ddtdanilo/Weather-Station-with-DemoQE128-Estacion-Meteorologica-/SINGUI_actual/data/refresh (2) .png

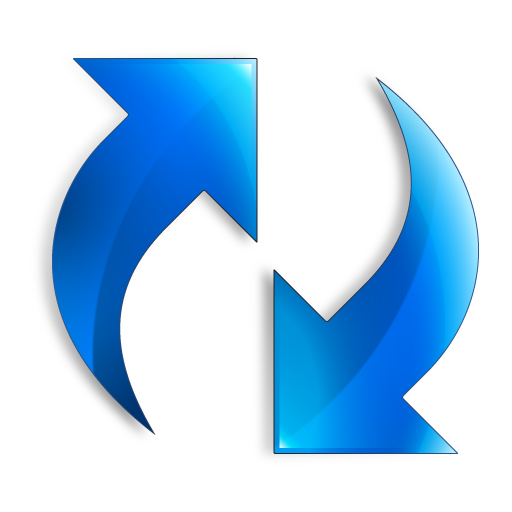
SINGUI_actual/data/refresh (2) .png
