ddtdanilo/Weather-Station-with-DemoQE128-Estacion-Meteorologica-/README.md

Estacion_Meteorologica_Proyectos_II_USB
=======================================

Código relacionado con la Estación Meteorológica -> MCU &amp; Interface PC

Este proyecto fue realizado en la Universidad Simón Bolívar por Danilo Díaz Tarascó e Irene Michelle López Carrón para el 
curso Laboratorio de Proyectos II. Consiste en una estación meteorológica con conexión a la nube, con el objetivo de monitorear
las condiciones de una planta y comunicárselas al usuario. Para esto se utilizaron diversos tipos de sensores, cuyos datos se
enviaron a un canal en ThingSpeak,  a una cuenta de Twitter y se mostraron en una interfaz gráfica desde la cual es usuario 
podía controlar, entre otras cosas, el tiempo de las mediciones.

Para mayor información, puede contactarme a través del siguiente correo: danilodt@gmail.com

Code related to the Weather Station -> MCU & amp; PC Interface 

This project was made at the Simon Bolivar University by Danilo Diaz Tarascó and Irene Michelle Lopez Carrón for the Laboratory of Projects II course. It consists of a weather station with connection to the cloud, in order to monitor the condition of a plant and communicate them to the user. For this, various kinds of sensors where used, taking those data to a ThingSpeak channel, a Twitter account and displayed on a graphical interface from which the user is able to control, among other things, the time of samble of the measurements. 

For more information, you can contact me through the following email: danilodt@gmail.com
