ddtdanilo/Weather-Station-with-DemoQE128-Estacion-Meteorologica-/Informe Final Proyectos II  - 1010211 y 1010391.pdf

## UNIVERSIDAD SIMÓ N BÓLI VAR

## DEPARTAMENTÓ DE ELECTRÓ NICA Y CIRCUITÓS

## LABÓRATÓRIÓ C

EC3882

## PRÓFESÓR: CALÓGERÓ BRUSCIANELLI

# INFORME TÉCNICO: ESTACIÓN METEOROLÓGICA

# LABORATORIO DE PROYECTOS 2

IRENE MICHELLE LÓ PEZ CARRÓ N - USBID: 10-10391.

# ÍNDICE

# TABLA DE CONTENIDOS

Central meteorolo gica para monitoreo de plantas por Medio de La Nube ____________________________________ 1 Implementacio n ___________________________________________________________________________________________________ 2 Sensor de temperatura y humedad del aire DHT11__________________________________________________________ 2 Medicio n de la intensidad de la luz: ___________________________________________________________________________ 4 Medicio n de la temperatura en el suelo: ______________________________________________________________________ 5 Medicio n de la humedad del suelo:____________________________________________________________________________ 7 Medicio n de la velocidad del viento: _________________________________________________________________________10 Tarjeta principal:_______________________________________________________________________________________________19 Microcontrolador: _____________________________________________________________________________________________20 Protocolo de Comunicaciones:________________________________________________________________________________26 Processing: _____________________________________________________________________________________________________27 Recomendaciones ________________________________________________________________________________________________31 Referencias ________________________________________________________________________________________________________32

# TABLA DE FIGURAS

# ÍNDICE

Figura 17 Diagrama de bloques del circuito receptor para el anemo metro ultraso nico | 12
Figura 18 Circuito para la tierra virtual del receptor | 13
Figura 19 Circuito para la etapa inicial de ganancia en el receptor | 13
Figura 20 Circuito para el filtro pasa alto en el receptor | 13
Figura 21 Respuesta en frecuencia del filtro pasa alto, conectado a la etapa inicial de ganancia | 14
Figura 22 Sen al Recibida y la Salida del Comparador (Medida del Error) | 15
Figura 23 Circuito para el comparador en el receptor | 15
Figura 24 Circuito para el divisor de voltaje en el receptor | 16
Figura 25 Circuito receptor del anemo metro ultraso nico para soldar en baquelita perforada | 16
Figura 26 Circuitos para los dos pares emisor-receptor del anemo metro | 17
Figura 27 Diagrama de flujo para el procesamiento de datos del anemo metro | 18
Figura 28 Tarjeta principal para la estacio n meteorolo gica | 19
Figura 29 Diagrama de flujo Microcontrolador, Main | 20
Figura 30 Diagrama de Flujo Interrupcio n Serial SCI1 | 21
Figura 31 Diagrama de Flujo de SCI2 (Proveniente del Sensor de Temperatura y Humedad) | 22
Figura 32 Diagrama de Flujo de la Medicio n de Tiempo 1 | 23
Figura 33 Diagrama de Flujo de la Medicio n de Tiempo 2 | 24
Figura 34 Diagrama de Flujo de la interrupcio n de ADC | 25
Figura 35 Diagrama de flujo del programa en Processing | 27
Figura 36 Interfaz gra fica del programa hecho con Processing | 28
Figura 37 Canal en ThingSpeak que almacena y muestra gra ficamente las mediciones de la estacio n | 29
Figura 38 Publicacio n en Twitter de las mediciones de la estacio n meteorolo gica | 30
Figura 39 Estacio n Metereolo gica | 31

# TABLAS

Tabla 1 Rangos de voltaje correspondientes a las tres categorí as de humedad | 9
Tabla 2 Mediciones Realizadas por el Microcontrolador | 22
Tabla 3 Trama de bytes del protocolo Serial | 26

## CENTRAL METEOROLÓGICA PARA MONITOREO DE PLANTAS POR MEDIO DE LA NUBE

Como proyecto para el curso Laboratorio de Proyectos II se construyo una estacio n meteorolo gica con conexio n a la nube, con el objetivo de monitorear las condiciones de una planta y comunica rselas al usuario. Para esto se utilizaron diversos tipos de sensores, cuyos datos se enviaron a un canal en ThingSpeak, a una cuenta de Twitter y se mostraron en una interfaz gra fica desde la cual es usuario podí a controlar, entre otras cosas, el tiempo de las mediciones.

A continuacio n se presenta un diagrama de bloques que resume la estructura ba sica de la central meteorolo gica para monitoreo de plantas:

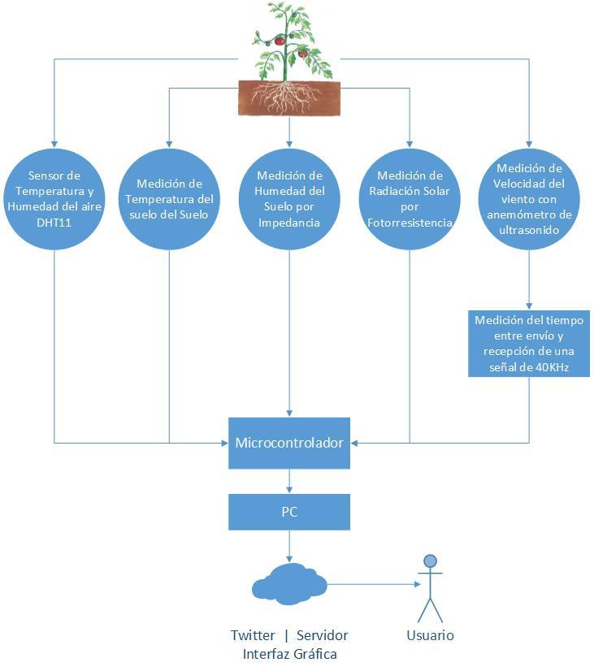
[picture p2: figure]

Figura 1 Diagrama de bloques de la central.

## IMPLEMENTACIÓN

Sensor de temperatura y humedad del aire DHT11

Este sensor se caracteriza por tener la sen al digital calibrada por lo que asegura una alta calidad y una fiabilidad a lo largo del tiempo, ya que contiene un microcontrolador de 8 bits integrado. Esta constituido por dos sensores resistivos. Puede medir la humedad entre el rango 20% – aprox. 95% y la temperatura entre el rango 0ºC – 50ºC.

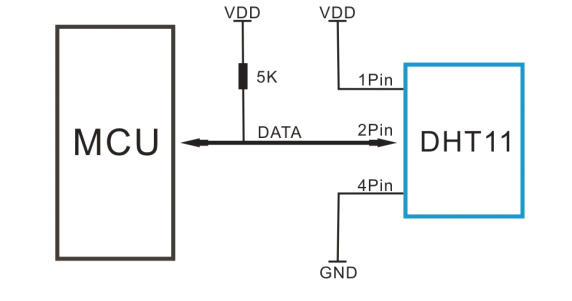
[picture p3: figure]

Figura 2 Implementación circuital del sensor DHT11

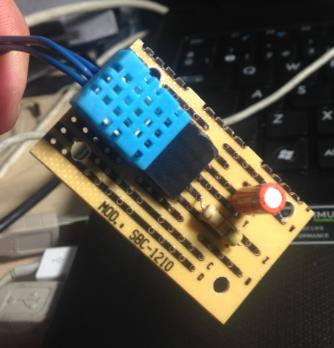
[picture p4: figure]

Figura 3 Sensor DHT11 en su baquelita

Dada la dificultad de implementacio n del protocolo de comunicaciones en el HCS08, se opto por hacer un driver mediante el uso del microcontrolador ATMEGA328PU, y conversores de niveles lo gicos, ya que se tení a la facilidad de usar una librerí a disponible de manera gratuita en la web.

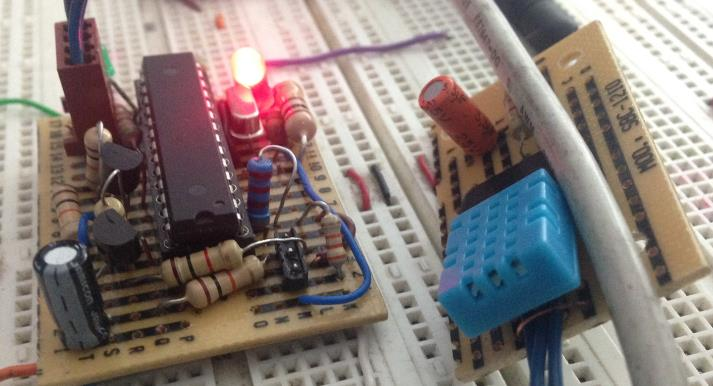
[picture p5: figure]

Figura 4 ATMEGA328PU como Driver del DHT11

La comunicacio n entre microcontroladores se realizo mediante el uso de puerto serial, utilizando el protocolo de comunicaciones explicado de manera detallada ma s adelante.

Medición de la intensidad de la luz:

En cuanto a la medicio n de intensidad de luz, se realizo el montaje de un sensor resistivo mediante la te cnica de divisor de tensio n. Los cambios de voltaje fueron registrados por el ADC del microcontrolador. En la siguiente figura, se puede observar el circuito implementado.

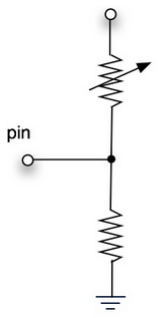
[picture p6: figure]

Figura 5 Divisor de la fotoresistencia

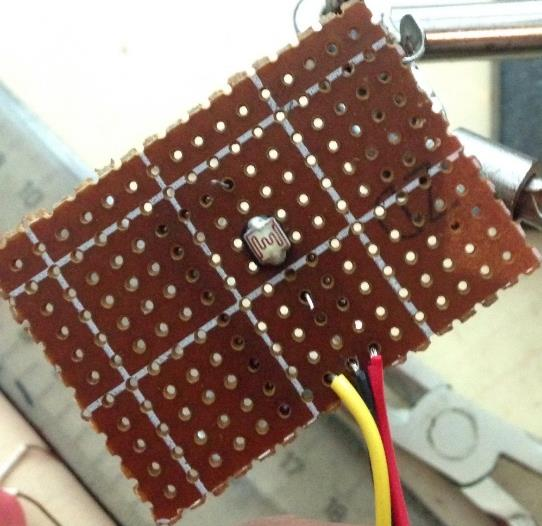
[picture p7: figure]

Figura 6 Sensor de Luminosidad

Para la calibracio n, se realizo el ca lculo de la resistencia del divisor tomando en cuenta los valores ma ximos y mí nimos que presentaba la fotoresistencia y el nu mero de bits de resolucio n del ADC (12 Bits).

La resolucio n final, para 2¹² = 4096, es de 0.7mV. Si se toma en cuenta que para ma xima luminosidad, se tiene una resistencia de 100 Ω, y para mí nima una resistencia de 30 MΩ, se puede llegar a una expresio n para la resistencia necesaria, que permita aprovechar toda la resolucio n del ADC. Se llego a que la resistencia debí a tener un valor aproximado a los 3.9 kΩ.

Medición de la temperatura en el suelo:

Para esta medicio n se empleo el termistor activo MCP9700A, cuyo voltaje de salida es directamente proporcional a la temperatura de su entorno y puede detectar temperaturas de 0°C a 70°C con un error de ±2°C y un consumo de corriente tí pico de 6 µA. Se decidio usar este tipo de sensor en lugar de un termistor resistivo por tener mayor inmunidad a las capacitancias parasitas y ser considerado ma s adecuado para implementaciones donde el sensor se encuentre alejado del circuito principal.

Figura 7 Termistor linear activo de baja potencia MCP9700A

El circuito para el sensor se disen o siguiendo las recomendaciones del Datasheet para disminuir el ruido en las mediciones y puede observarse en la figura 8. La parte del circuito que se enterrara en el suelo comprende el termistor, un condensador de desacoplo y una resistencia, los cuales fueron recubiertos en termoencogible y silico n, como se observa en la figura 9, de forma que no fueran afectados por la humedad del suelo.

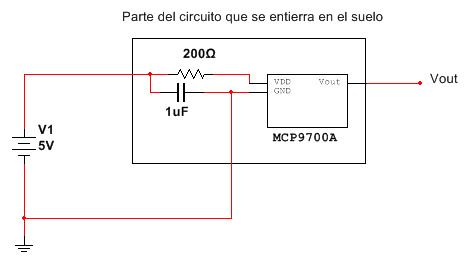
[picture p8: figure]

Figura 8 Circuito para el sensor de temperatura del suelo

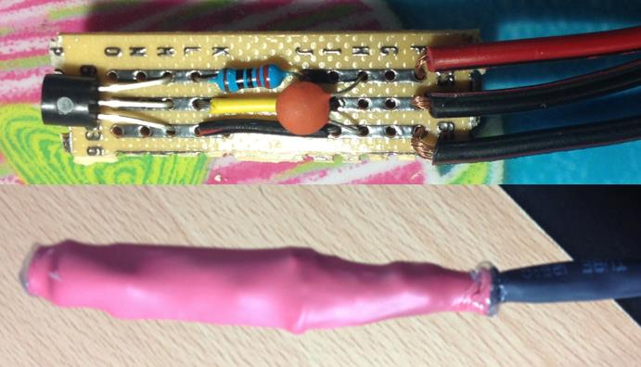
[picture p9: figure]

Figura 9 Sensor de temperatura del suelo, antes y después de cubrirlo

Se decidio conectar la salida del sensor directamente a un pin del microcontrolador, pues la ma xima corriente de salida especificada en el Datasheet es de 100uA, mientras que el ma ximo voltaje de salida es de aproximadamente 1.75V, como puede observarse en la siguiente gra fica:

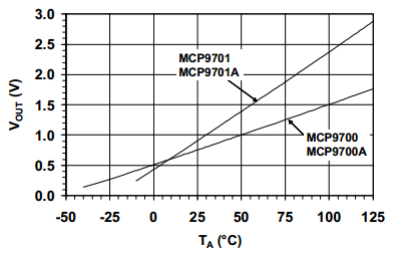
[picture p10: figure]

Figura 10 Voltaje de Salida vs. Temperatura para una alimentación entre 1.5V y 5.5V

Para obtener la temperatura a partir del voltaje de salida del sensor, se aplico la siguiente fo rmula:

Temperatura =

(Vout_sensor ∗

3
4096)− 0.5

0.01

Donde 3 es el voltaje ma ximo en el pin analo gico, 4096 es 2

12 , la resolucio n del conversor analo gico-digital, 0.5 equivale a 500mV, el voltaje de salida del sensor para 0°C y 0.01 representa el factor de 10mV/°C del sensor.

Medición de la humedad del suelo:

Para medir la humedad del suelo se empleo el circuito que puede observarse en la figura 11. Los clavos meta licos se entierran en el suelo, que actu a como una resistencia variable, conduciendo electricidad en mayor o menor medida, dependiendo de su humedad. La resistencia del suelo disminuye cuando aumenta la cantidad de agua que contiene e incrementa a medida que se seca; esto implica que con el circuito utilizado, mientras mayor sea la humedad del suelo, mayor sera el voltaje en el pin analo gico.

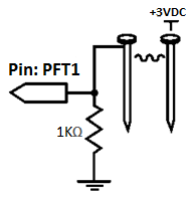
[picture p11: figure]

Figura 11 Circuito para medición de humedad en el suelo

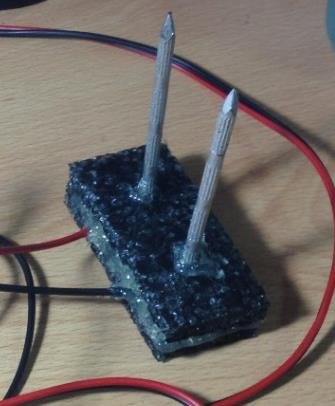
[picture p12: figure]

Figura 12 Terminales metálicos

Al medir con un multí metro la resistencia entre los terminales meta licos, enterrados en la tierra de una maceta, se observo que la medicio n variaba ligeramente de un instante a otro, aunque la temperatura y humedad se mantení an constantes. Esto se debí a a que los clavos empleados no eran adecuados, pues no se encontraban galvanizados y empezaban a sufrir un proceso de electro lisis al estar en contacto con el agua y tener una corriente circulando entre ellos. Adicionalmente, el sensor tení a que mantenerse un tiempo prolongado en la tierra, para obtener una medicio n lo suficientemente estable.

Tomando en cuenta ambos factores se decidio no mostrar la humedad en porcentajes, como se tení a planeado inicialmente, optando por dar a la medicio n un enfoque ma s pra ctico y enfocado al usuario final; para esto se dividio la humedad del suelo en tres categorí as: “Baja”, “Ó ptima” y “Excesiva”.

Para medir de forma adecuada la humedad del suelo, fue necesario considerar tambie n su temperatura, pues cuando e sta aumenta la resistencia del suelo disminuye y al bajar la temperatura la resistencia se incrementa.

Como las propiedades del suelo varí an de acuerdo a su tipo y a los minerales que contenga, se tuvo que encontrar de forma pra ctica la relacio n entre la resistencia y temperatura, pudiendo observarse la gra fica obtenida en la figura 13. Las mediciones se realizaron usando una mezcla de 200cc de agua con 60cc de tierra, para garantizar que la humedad no disminuyera con la evaporacio n al calentar la mezcla y que no aumentara al colocarla en el congelador para disminuir su temperatura.

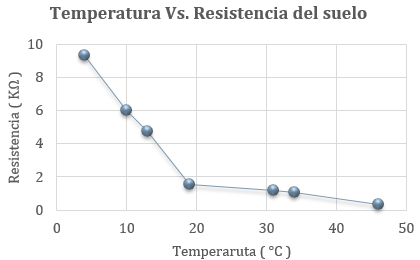
[picture p13: figure]

Figura 13 Gráfica de Temperatura Vs. Resistencia del Suelo

Como la variacio n de resistencia fue muy baja entre 19°C y 31°C, se decidio considerarla constante para dicho intervalo. Al realizar la correccio n de la resistencia en el co digo, se considero una recta con pendiente -500 para temperaturas menores a los 19°C y otra con pendiente -58 para temperaturas superiores a los 31°C, de forma que la resistencia “real”, llevada al intervalo entre 19°C y 31°C, pudiera obtenerse mediante la aplicacio n de una de las siguientes fo rmulas, segu n correspondiera:

Resistencia real = −500 ∗ ( 19 − temperatura medida, menor a 19°C)+ Resistencia medida

ó

Resistencia real = −58 ∗ ( 31 − temperatura medida, mayor a 31°C)+ Resistencia medida

Óbteniendo el voltaje en la salida del divisor con la siguiente relacio n: Voltaje real =

1kΩ ∗3V
Resistencia real+ 1kΩ

Para finalizar se midio a 25°C el voltaje a la salida del divisor, estableciendo los rangos correspondientes a las tres clasificaciones de humedad:

Humedad | Baja | Óptima | Excesiva
Voltaje en el pin analógico | Menor a 0.84V | Entre 0.84V y 1.69V | Mayor a 1.69V

Tabla 1 Rangos de voltaje correspondientes a las tres categorías de humedad

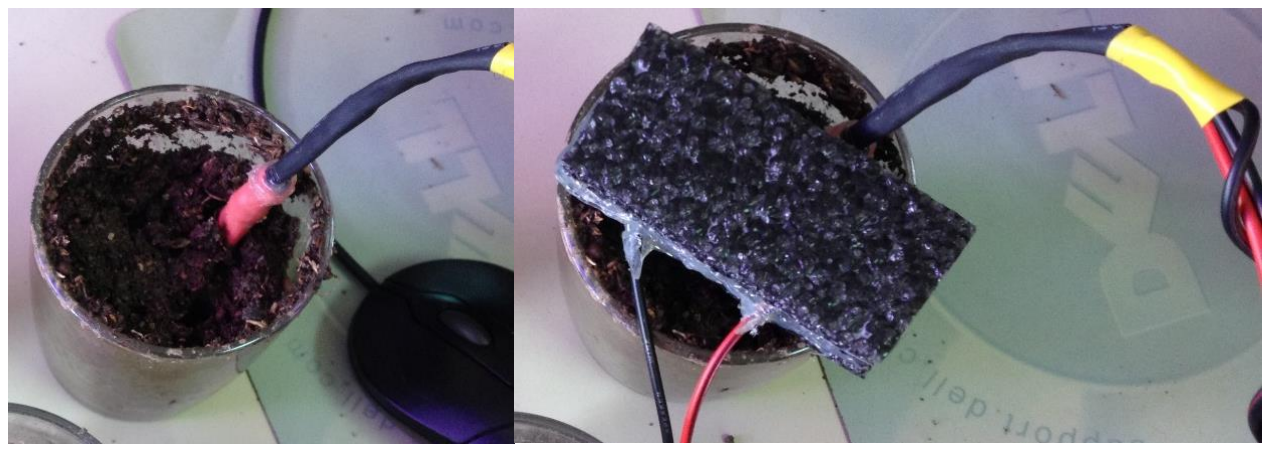
[picture p14: figure]

Figura 14 Medición de la humedad del suelo, con corrección de temperatura

Medición de la velocidad del viento:

Para realizar e sta medicio n se construyo un anemo metro de ultrasonido, que funciona mediante la medicio n del tiempo que tarda una sen al a 40KHz en llegar del emisor a un receptor ubicado frente a e l, a una distancia D conocida. El instrumento construido puede observarse en la figura 15 y cuenta con 4 cornetas, dos de las cuales actu an como emisor y las otras dos como receptor.

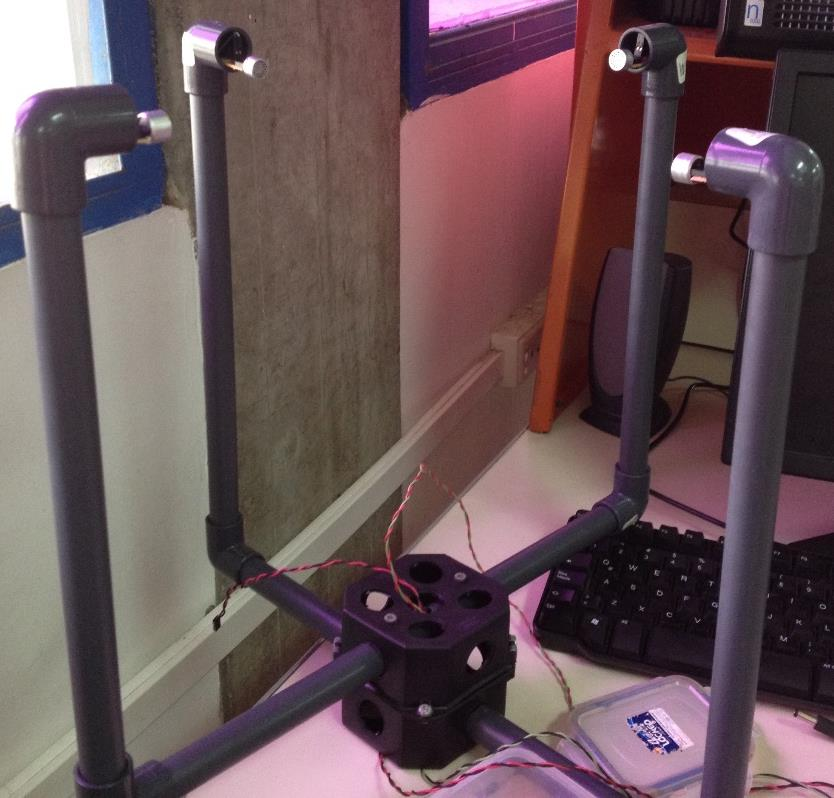
[picture p15: figure]

Figura 15 Anemómetro ultrasónico.

El funcionamiento de e ste dispositivo se basa en lo siguiente: Suponiendo que se tienen los sensores separados a una distancia D, el tiempo que tarda la sen al desde el emisor 1 hasta el receptor 1 con viento es:

t1 = D/(vs ±Vx)

Dado que la velocidad del sonido (vs) es lineal y proporcional a la temperatura, para temperaturas cercanas a la ambiente, se obtiene la velocidad del sonido haciendo uso de la temperatura obtenida con el sensor DHT11:

vs ≈ 331.4 +0.61 · temp [1]

Usando las fo rmulas anteriores se obtiene la componente de la velocidad del viento Vx y aplicando el mismo procedimiento en un segundo par emisor-receptor, ubicado de forma perpendicular al primero, se obtiene la otra componente de la velocidad del viento, Vy. De esta manera se puede obtener la velocidad V del viento y su a ngulo α de incidencia, mediante:

α = arctan(

Vy
Vx)

V = √Vx
2 + Vy

2

◊ Emisor ultrasónico:

Se genera una PWM con el microcontrolador, de frecuencia de 40KHz y que se enví a hasta que se detecta el primer flanco de bajada en el receptor. Dicha sen al tiene un voltaje ma ximo de 3 voltios, lo cual no es suficiente para el emisor ultraso nico, que es poco eficiente y necesita recibir una sen al de alto voltaje, de forma que el receptor pueda captarla despue s de las perdidas y contaminacio n con ruido.

Por esa razo n, la sen al del microcontrolador se usa como entrada para el circuito de la figura 16, el cual aumenta el voltaje de la sen al recibida a 15 voltios. A la entrada “SIG-“ se conecta la salida de una compuerta lo gica Not o Inversor, que invierte la sen al obtenida del microcontrolador; dicha sen al se emplea directamente para la entrada “SIG+”. De esta forma solo es necesario generar con el microcontrolador una PWM por cada par emisor-receptor.

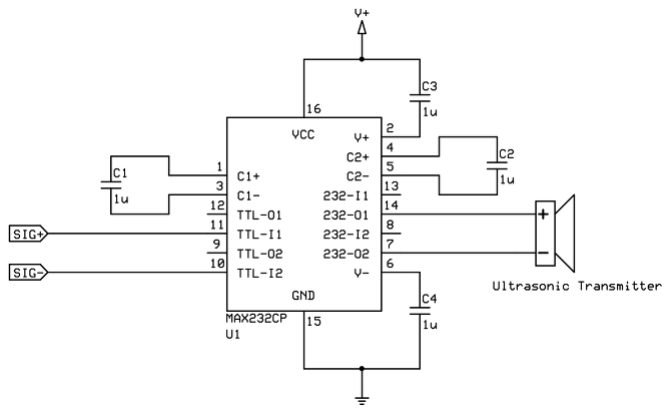
[picture p16: figure]

Figura 16 Circuito para el emisor del anemómetro ultrasónico

Cuando el microcontrolador genera la PWM, empieza un contador que se detendra al llegar la sen al al receptor, enviando por serial el tiempo de tra nsito medido.

◊ Receptor ultrasónico:

La sen al captada por el receptor ultraso nico era de bajo voltaje y se encontraba muy contaminada por ruido de frecuencia 60Hz, proveniente de las lí neas ele ctricas. Por ello, resulto necesario acondicionar la sen al antes de enviarla al microcontrolador.

En la figura 17 se puede observar el diagrama de bloques del circuito de acondicionamiento para la sen al captada por el receptor ultraso nico.

El bloque de nombre “GNDV” es la tierra virtual, una sen al DC de 2,5 voltios. Es necesario emplear una tierra virtual para los bloques de amplificacio n y filtro pasa alto, pues en ambos se utiliza un amplificador operacional, alimentado en modo single supply, de 0 a 5 voltios; la tierra virtual actu a como un offset, subiendo el nivel de la sen al, que originalmente puede tener componentes negativas, no aceptables para un amplificador alimentado u nicamente con voltajes positivos.

Los circuitos para la tierra virtual, etapa inicial de ganancia y filtro pasa alto activo, pueden observarse en las ima genes 18, 19 y 20 respectivamente. No se coloco un filtro pasa bajo para antisolapamiento, pues la ganancia del filtro pasa alto en conjunto con el ancho de banda del amplificador utilizado, el LM324N, hacen que el filtro pasa alto se comporte como un pasa banda. En la figura 21 se encuentra la respuesta en frecuencia del filtro pasa alto conectado a la etapa de ganancia y como se puede observar, para una frecuencia de 40KHz ya empieza a presentarse una reduccio n de la ganancia, lo que confirma que la implementacio n de un filtro pasa bajo no es necesaria.

Figura 17 Diagrama de bloques del circuito receptor para el anemómetro ultrasónico

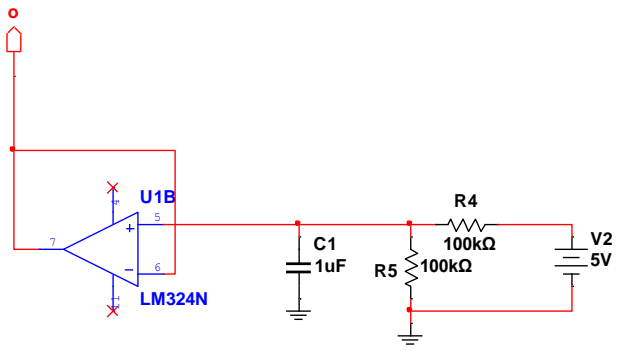
[picture p17: figure]

Figura 18 Circuito para la tierra virtual del receptor

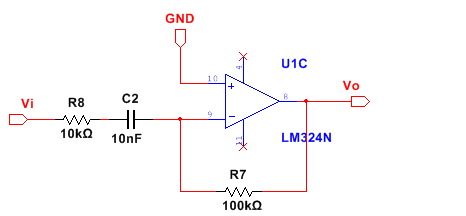
[picture p18: figure]

Figura 19 Circuito para la etapa inicial de ganancia en el receptor

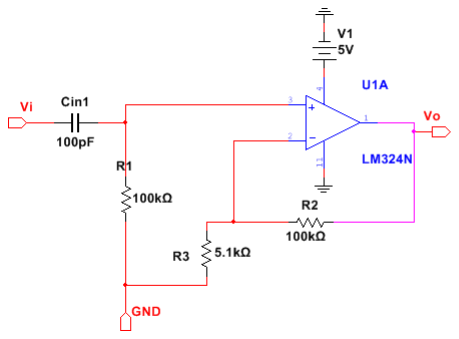
[picture p19: figure]

Figura 20 Circuito para el filtro pasa alto en el receptor

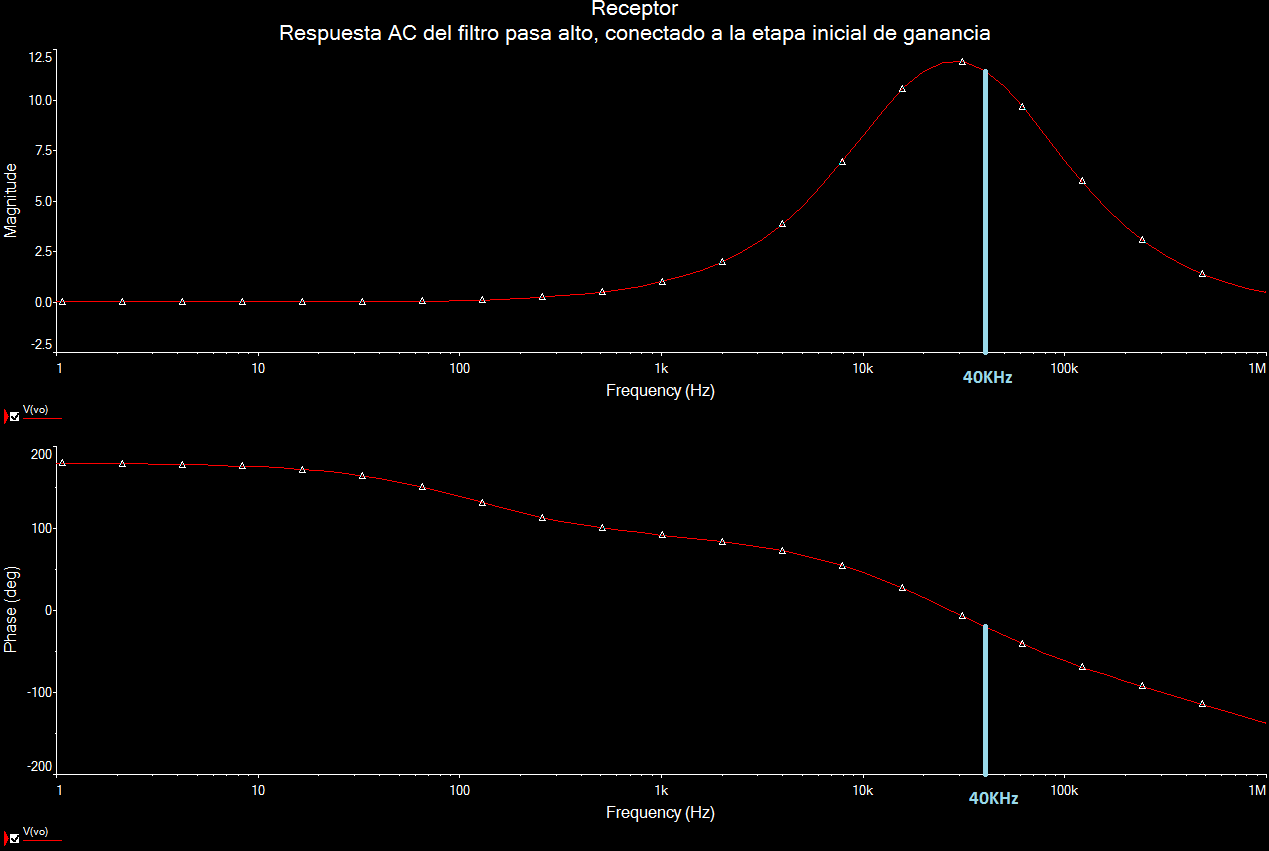
[picture p20: figure]

Figura 21 Respuesta en frecuencia del filtro pasa alto, conectado a la etapa inicial de ganancia

En la figura 23, se puede observar un circuito que emplea el LM311P. Su propo sito es comparar la sen al proveniente del filtro pasa alto, “Vin”, con un voltaje de comparacio n o threshold. Cuando el voltaje de “Vin” es mayor al de comparacio n, la salida del comparador es un DC de 5 voltios, en caso contrario dicha salida es cero. Se opto por usar un potencio metro para establecer el voltaje de comparacio n, de forma que el circuito fuera ma s pra ctico de calibrar; para elegir dicho voltaje se consideraron los siguientes factores:

- La sen al presentaba ruido de alta frecuencia, en apariencia aleatorio, elevado tambie n por el offset de 2.5V y que podí a tener picos mayores a 500mV.
- El amplificador operacional utilizado se saturaba a un voltaje de aproximadamente 3.5 voltios.

Tomando ambos hechos en cuenta, se decidio usar un voltaje de comparacio n de 800mV, de forma que la salida del comparador se mantuviera siempre en 5V y bajara a 0V al recibir el primer flanco de bajada de la sen al. Con esto se garantizo que ningu n pico del ruido pudiera confundirse por la llegada de la sen al, la cual tení a una voltaje pico de aproximadamente 2 Voltios, llegando de 500mV a los 3.5V que permití a el amplificador.

Con el nuevo voltaje de comparacio n se comprobo que el receptor no confundí a los picos de ruido con la sen al del emisor, sin embargo, se presentaba de forma espora dica un incremento en la velocidad medida, aun en ambientes cerrados y pra cticamente sin viento. A trave s de mu ltiples mediciones, se observo que dicho aumento siempre se encontraba alrededor de 25us y el estudio de la onda recibida con el osciloscopio permitio llegar a la conclusio n de que en ocasiones la atenuacio n de la sen al durante el enví o era excesiva y no se lograba detectar el primer ciclo de la sen al; se incremento la amplificacio n de la segunda etapa de ganancia y el voltaje de comparacio n, pero aun así se seguí a perdiendo espora dicamente el primer ciclo de la sen al, por lo que se opto por hacer un promedio de diez mediciones en el co digo, de forma que el error en una de ellas no afectara de forma significativa la velocidad final obtenida. Dicha solucio n permitio obtener valores mucho ma s estables en la medicio n y no ralentizo el co digo, pues cada medicio n de tiempo tomaba menos de 2ms.

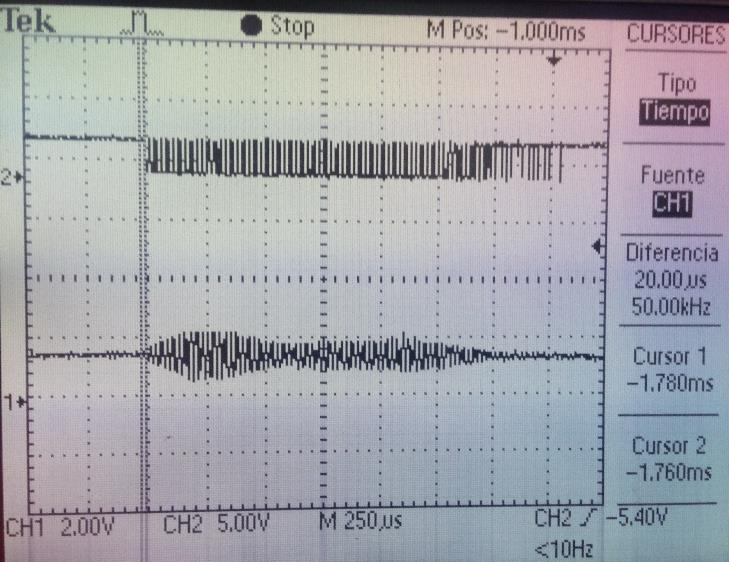
[picture p21: figure]

Figura 22 Señal Recibida y la Salida del Comparador (Medida del Error)

Como el microcontrolador solo acepta entradas de 0 a 3 voltios y el comparador genera sen ales entre 0 y 5 voltios, fue necesario usar un divisor de voltaje como el que puede observarse en la figura 24. Cuando el microcontrolador detecta el primer flanco de bajada en la sen al de salida del divisor, se detiene el contador y se enví a la medida al programa en Processing, donde se realizan correcciones en el tiempo medido, multiplica ndolo por el step del contador y suma ndole una constante obtenida al calibrar el anemo metro en un espacio sin viento, donde la velocidad de la onda de 40KHz debí a ser igual a la velocidad del sonido.

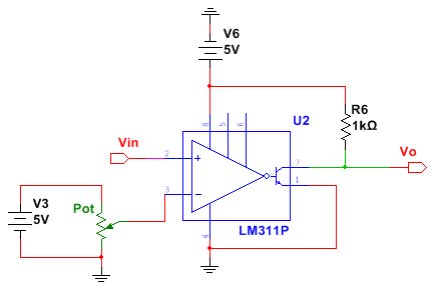
[picture p22: figure]

Figura 23 Circuito para el comparador en el receptor

Figura 24 Circuito para el divisor de voltaje en el receptor

Cada par emisor-receptor requerí a un circuito como el de la figura 25, por ello, se decidio organizar ambos circuitos para que la tarjeta correspondiente al segundo par, encajara sobre la del primero, de tal forma que el circuito inferior recibiera la alimentacio n y las sen ales del microcontrolador, mientras que en el circuito superior solo se conectaban las cuatro cornetas. El resultado obtenido puede observarse en la figura 26.

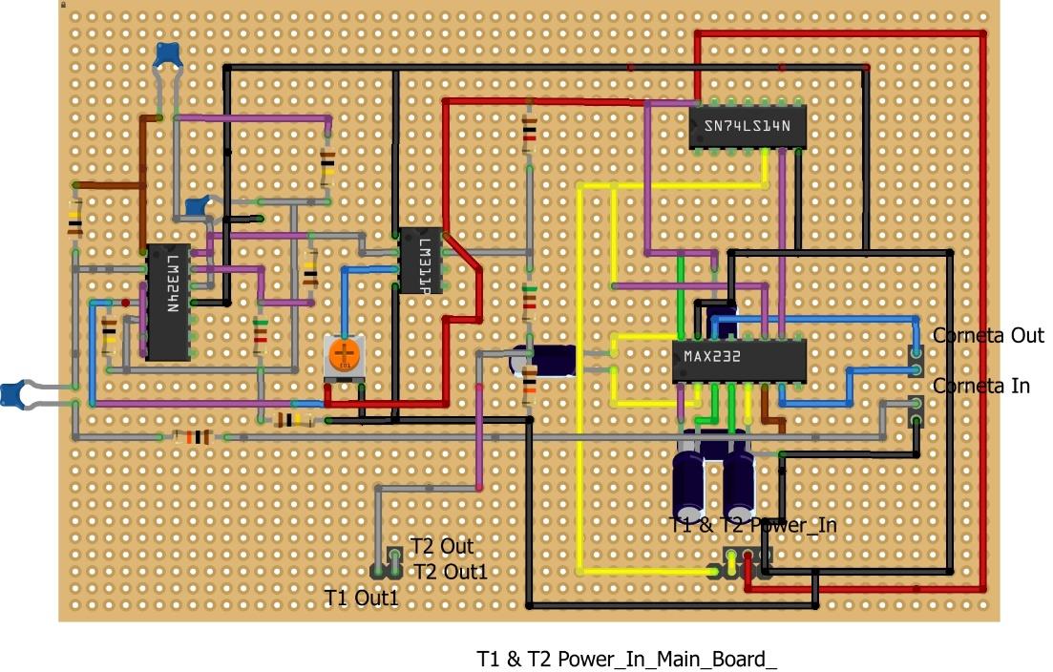
[picture p23: figure]

Figura 25 Circuito receptor del anemómetro ultrasónico para soldar en baquelita perforada

IO1 | R9 | IO2
| 47kΩ
| | R12

56kΩ

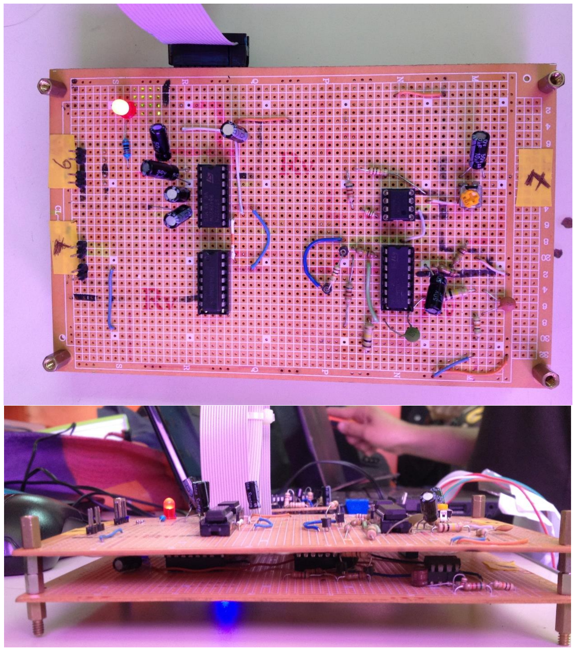
[picture p24: figure]

Figura 26 Circuitos para los dos pares emisor-receptor del anemómetro

A continuacio n se tiene un diagrama de flujo para el procesamiento de datos provenientes del anemo metro.

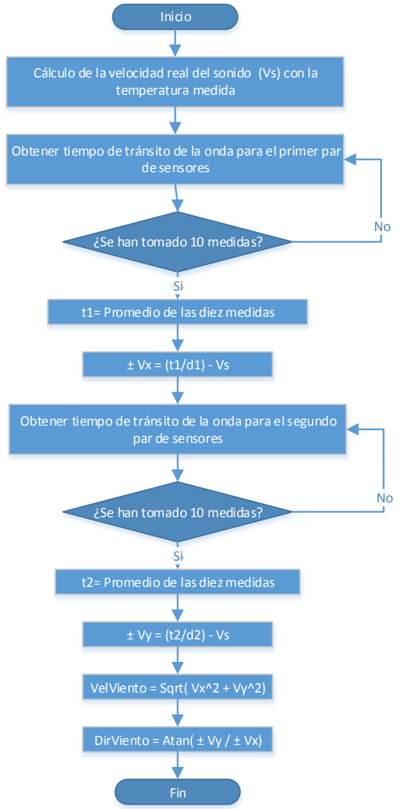
[picture p25: figure]
Inicio; temperatura medida; de sensores; par de sensores; Fin; ¿Se han tomado 10 medidas?; t1= Promedio de las diez medidas; t2= Promedio de las diez medidas; VelViento = Sqrt( Vx^2 + Vy^2); DirViento = Atan( ± Vy / ± Vx)

Cálculo de la velocidad real del sonido (Vs) con la

Obtener tiempo de tránsito de la onda para el primer par

Obtener tiempo de tránsito de la onda para el segundo

Figura 27 Diagrama de flujo para el procesamiento de datos del anemómetro

Tarjeta principal:

Una vez construidos los sensores de forma individual, resulto necesaria una tarjeta principal donde se conectaran todos, para alimentarlos y comunicarlos con el microcontrolador. En dicha tarjeta se coloco un conector para el microcontrolador y los distintos conectores requeridos por cada sensor. Tambie n se agrego un conector para puerto serial inala mbrico y la alimentacio n de 5 voltios, para la cual se uso un regulador de 5 voltios, con un capacitor de 100uF en paralelo a otro de 0.1uF a la salida, con propo sito de filtrado. El circuito obtenido se puede observar en la siguiente figura:

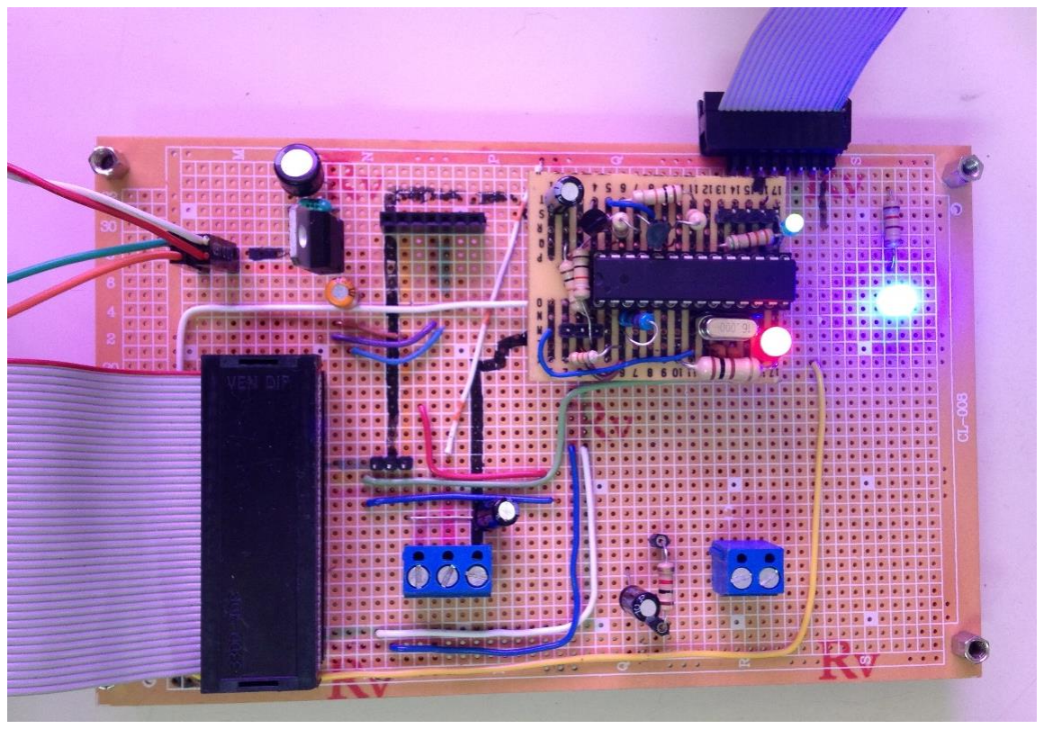
[picture p26: figure]

Figura 28 Tarjeta principal para la estación meteorológica

Microcontrolador:
Los datos se obtendra n a trave s del microcontrolador, que a su vez se comunicara por un protocolo de comunicacio n a disen ar con la plataforma PC. Esta plataforma permitira enviar a la nube los datos adquiridos mediante la aplicacio n desarrollada en Processing.

Dada la cantidad de procesos que el microcontrolador debí a llevar a cabo, se decidio atacar este problema de co mputo mediante el uso modular de interrupciones, dado que facilitan la implementacio n del co digo necesario de manera modular y separada.

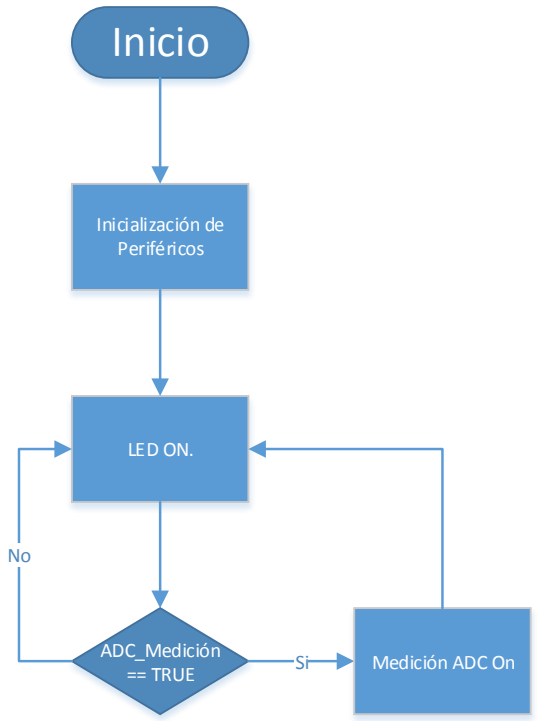
[picture p27: figure]
Inicio; Inicialización de Periféricos; LED ON.; ADC_Medición; == TRUE; Medición ADC On

Figura 29 Diagrama de flujo Microcontrolador, Main

Para la recepcio n serial SCI1, que se debí a comunicar con la PC, se implemento una estructura switch, que permitio separar las peticiones de la PC. En esta estructura se realiza el algoritmo correspondiente a cada una de las mediciones.

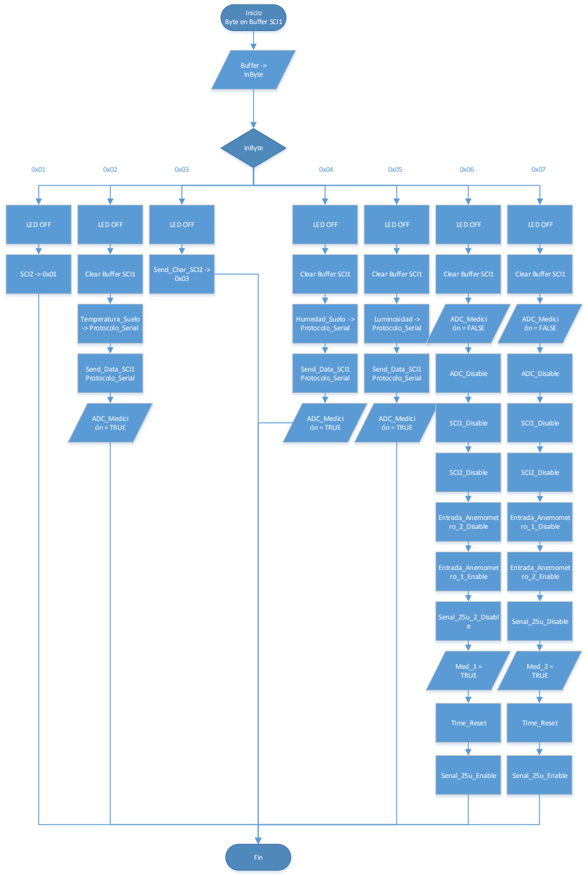
[picture p28: figure]
Inicio Byte en Buffer SCI1; Buffer -> inByte; LED OFF; inByte; SCI2 -> 0x01; Clear Buffer SCI1; Temperatura_Suelo -> Protocolo_Serial; Send_Data_SCI1 Protocolo_Serial; Send_Char_SCI2 ->; Humedad_Suelo -> Protocolo_Serial; Luminosidad -> Protocolo_Serial; ADC_Medici ón = TRUE; ADC_Medici ón = FALSE; ADC_Disable; SCI1_Disable; SCI2_Disable; Entrada_Anemomet ro_2_Disable; Entrada_Anemomet ro_1_Enable; Senal_25u_2_Disabl e; Med_1 = TRUE; Time_Reset; Senal_25u_Enable; Entrada_Anemomet ro_1_Disable; Entrada_Anemomet ro_2_Enable; Senal_25u_Disable; Med_2 = TRUE; Fin

Figura 30 Diagrama de Flujo Interrupción Serial SCI1

En la siguiente tabla se puede observar las mediciones que realiza el microcontrolador y los respectivos nu meros hexadecimales para ser solicitados mediante el puerto serial SCI1.

Medición | Número Hexadecimal
Temperatura Ambiental | 0x01
Temperatura del Suelo | 0x02
Humedad del Ambiente | 0x03
Humedad del Suelo | 0x04
Luminosidad | 0x05
Tiempo de Anemómetro 1 | 0x06
Tiempo de Anemómetro 2 | 0x07

Tabla 2 Mediciones Realizadas por el Microcontrolador

Dado que la medicio n de Temperatura y humedad del ambiente se realizan en el sensor DHT11, se debe comunicar mediante el driver disen ado. A continuacio n se puede ver el diagrama de flujo de la interrupcio n del SCI2, que interactu a con el ATMEGA328PU.

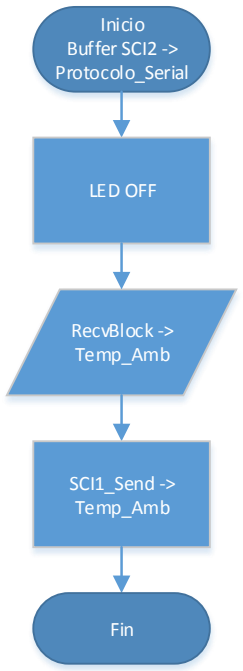
[picture p29: figure]
Inicio Buffer SCI2 -> Protocolo_Serial; LED OFF; RecvBlock -> Temp_Amb; SCI1_Send -> Temp_Amb; Fin

Figura 31 Diagrama de Flujo de SCI2 (Proveniente del Sensor de Temperatura y Humedad)

En cuanto a la medicio n de tiempo de tra nsito de la sen al generada de 40 kHz, en el eje X y el eje Y (Componentes de la velocidad del tiempo), les corresponde los siguientes diagramas de flujo.

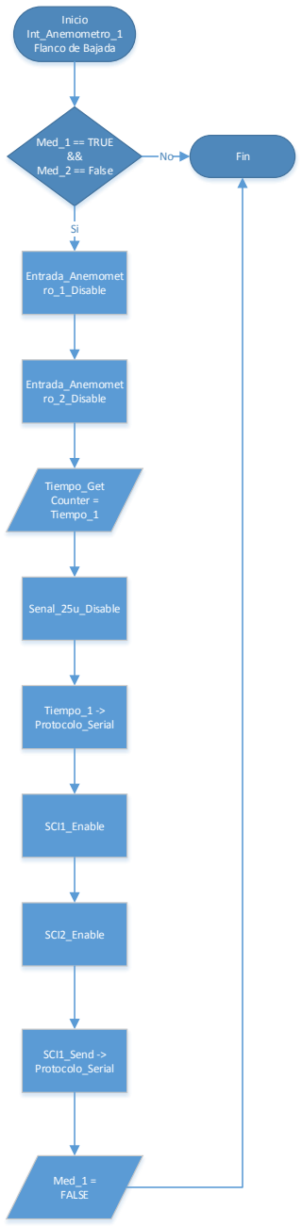
[picture p30: figure]
Inicio Int_Anemometro_1 Flanco de Bajada; Med_1 == TRUE && Med_2 == False; Entrada_Anemomet ro_1_Disable; Fin; Entrada_Anemomet ro_2_Disable; Tiempo_Get Counter = Tiempo_1; Senal_25u_Disable; Tiempo_1 -> Protocolo_Serial; SCI1_Enable; SCI2_Enable; SCI1_Send -> Protocolo_Serial; Med_1 = FALSE

Figura 32 Diagrama de Flujo de la Medición de Tiempo 1

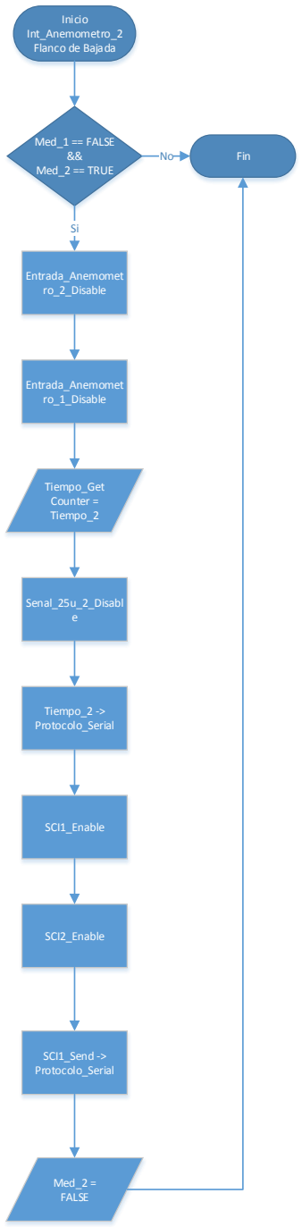
[picture p31: figure]
Inicio Int_Anemometro_2 Flanco de Bajada; Med_1 == FALSE && Med_2 == TRUE; Entrada_Anemomet ro_2_Disable; Fin; Entrada_Anemomet ro_1_Disable; Tiempo_Get Counter = Tiempo_2; Senal_25u_2_Disabl e; Tiempo_2 -> Protocolo_Serial; SCI1_Enable; SCI2_Enable; SCI1_Send -> Protocolo_Serial; Med_2 = FALSE

Figura 33 Diagrama de Flujo de la Medición de Tiempo 2

La manera como se disen o el co digo de obtencio n de tiempo de tra nsito, permitio que se realizara la medicio n de manera que el tiempo se viera afectado en lo ma s mí nimo por los dema s perife ricos, mediciones, eventos, etc.

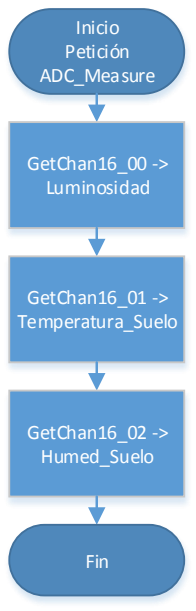
[picture p32: figure]
Inicio Petición ADC_Measure; GetChan16_00 -> Luminosidad; GetChan16_01 -> Temperatura_Suelo; GetChan16_02 -> Humed_Suelo; Fin

Figura 34 Diagrama de Flujo de la interrupción de ADC

En cuanto a la figura anterior, se puede observar que cuando la interrupcio n del ADC se lleva a cabo, realiza mediciones con una resolucio n de 16 Bits, y se guardan los valores para su posterior enví o.

Protocolo de Comunicaciones:

Un protocolo de comunicaciones es un conjunto de reglas y normas que permiten que dos o ma s entidades de un sistema se comuniquen para transmitir de relevancia. Se trata de las reglas o esta ndares que define la sintaxis, sema ntica y sincronizacio n de la comunicacio n, así como posibles me todos de recuperacio n de errores. Los protocolos pueden ser implementados por hardware, software, o una combinacio n de ambos.

Para el caso de la comunicacio n entre el microcontrolador, la PC y el Atmel328PU, se disen o un protocolo de comunicaciones digital, adecuado a la transmisio n por puerto serial. Este protocolo consta de una trama de cinco bytes, como se puede ver a continuacio n.

** | ** | ** | ** | 0XFF
0 | 1 | 2 | 3 | 4
Tabla 3 Trama de bytes del protocolo Serial.

Cada uno de estos Byte indica informacio n relevante para el receptor.

- Byte 0: Indica el tipo de dato enviado (Sensor).
- Byte 1: Indica DATA1, los bits ma s significativos de la medida.
- Byte 2: Indica DATA2, los bits menos significativos de la medida.
- Byte 3: Indica si en DATA1 o en DATA2 hubo 0xFF. Si fue en DATA1, enví a 0x01, si fue en DATA2, enví a 0x02, si fue en DATA1 y DATA2, enví a 0x03. Caso contrario enví a 0x00 (No hay 0xFF en la medida).
- Byte 4: Indica el fin de la trama enviada con 0xFF.

Este protocolo tiene como bondad, que se puede realizar una transmisio n de 16 Bit de informacio n, con indicacio n del tipo de dato y fin de trama.

Processing:

Para el procesamiento de los datos obtenidos por el microcontrolador y la comunicacio n con el usuario, se empleo un co digo en Processing 1.0, el cual hacia uso de varias librerí as, entre ellas twitter4j para publicar los datos en twitter y G4P para construir la interfaz gra fica con mayor facilidad. En la siguiente figura se puede observar el diagrama de flujo del funcionamiento principal del programa:

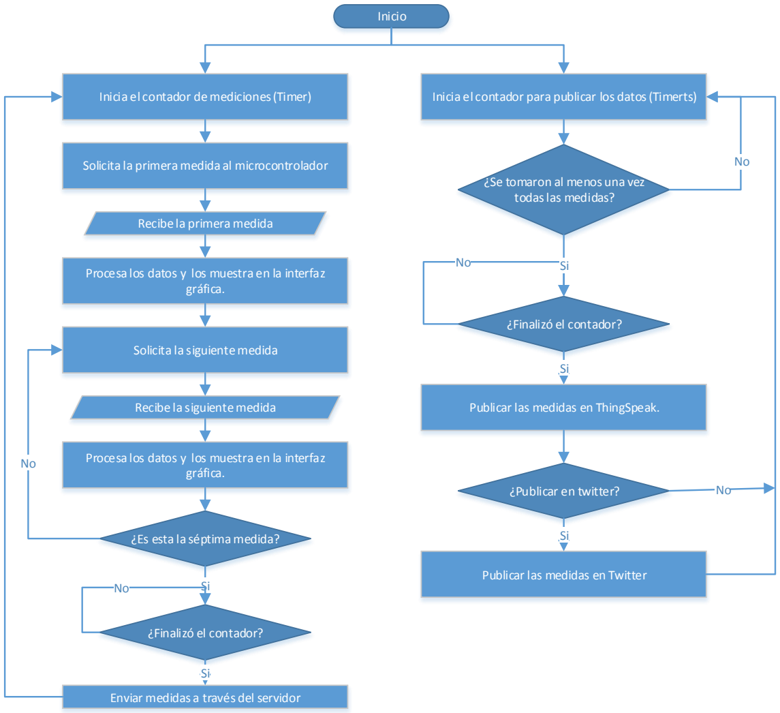
[picture p33: figure]
Inicio; ¿Es esta la séptima medida?; Recibe la primera medida; gráfica.; Recibe la siguiente medida; Solicita la siguiente medida; ¿Finalizó el contador?; ¿Se tomaron al menos una vez todas las medidas?; Enviar medidas a través del servidor; Publicar las medidas en ThingSpeak.; ¿Publicar en twitter?; Publicar las medidas en Twitter

Inicia el contador de mediciones (Timer)

Solicita la primera medida al microcontrolador

Inicia el contador para publicar los datos (Timerts)

Procesa los datos y los muestra en la interfaz

Procesa los datos y los muestra en la interfaz

Figura 35 Diagrama de flujo del programa en Processing

La interfaz gra fica del programa se puede observar en la siguiente figura y permite elegir el puerto serial a utilizar, la frecuencia con la cual se realizan las mediciones y si se publicaran o no en twitter; tambie n permite realizar mediciones de forma individual al presionar el boto n de “refrescar”, ubicado al lado de la medicio n correspondiente. Para la medicio n de velocidad y direccio n del viento se agrego una flecha que muestra en grados la direccio n y varí a su longitud, segu n la velocidad medida.

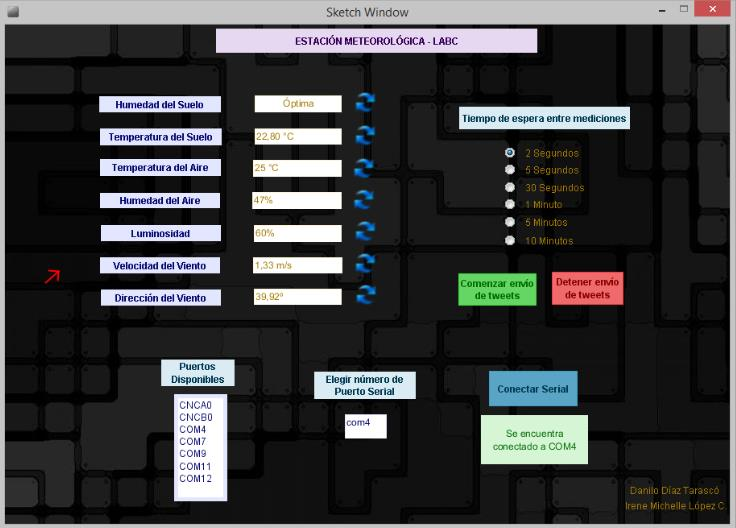
[picture p34: figure]

Figura 36 Interfaz gráfica del programa hecho con Processing

Como uno de los objetivos de la estacio n meteorolo gica era poder monitorear las variables de forma remota, se creo una cuenta de Twitter y un Canal en ThingSpeak para publicar las mediciones. Una muestra de la informacio n publicada en ambas pa ginas se puede observar en las siguientes ima genes:

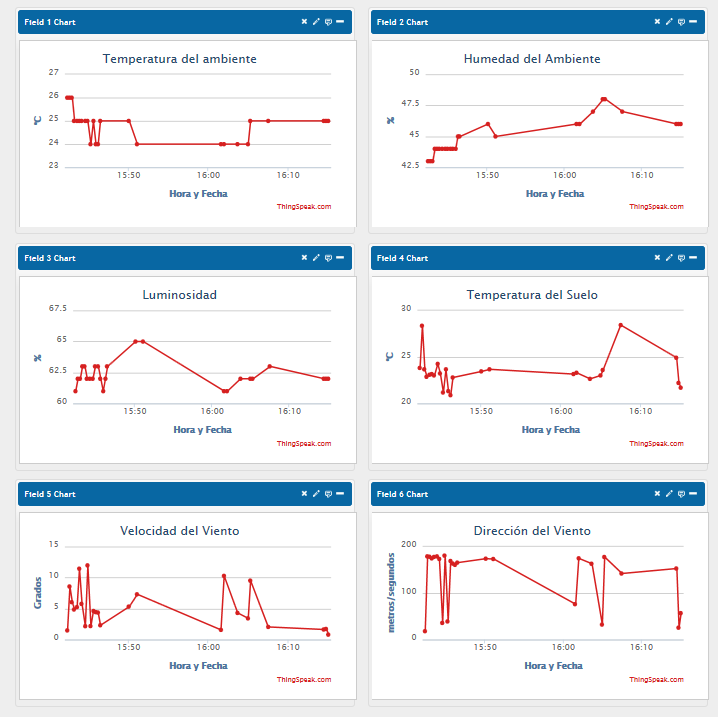
[picture p35: figure]

Figura 37 Canal en ThingSpeak que almacena y muestra gráficamente las mediciones de la estación

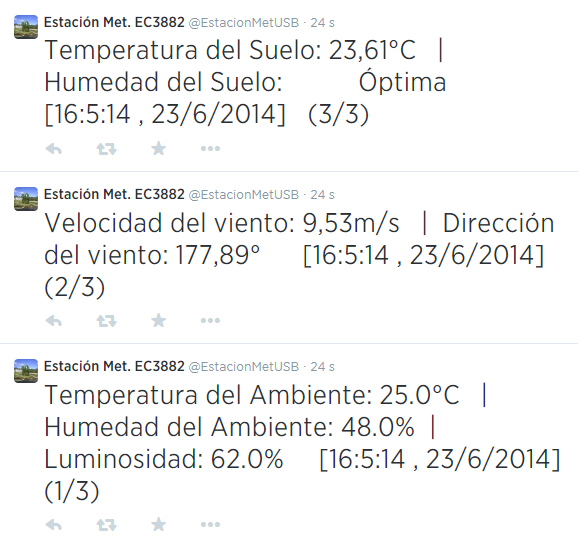
[picture p36: figure]

Figura 38 Publicación en Twitter de las mediciones de la estación meteorológica

### RECOMENDACIONES

El resultado del proyecto fue satisfactorio, pero se recomienda para su pro xima versio n los siguientes puntos:

- Si bien habí a la posibilidad de realizar una multiplexacio n de los emisores y receptores ultraso nicos, si no se desea obtener la temperatura, se recomienda el uso de emisores y receptores fijos es una buena solucio n, ya que la calibracio n es sencilla.
- Se recomienda conseguir clavos galvanizados para evitar la electro lisis en el circuito de sensor de humedad del suelo.
- Si se dispone de tiempo, es recomendable desarrollar una librerí a que permita utilizar el DHT11 directamente con el HCS08.
- Se recomienda comparar la medicio n de viento con un anemo metro comercial para una calibracio n ma s precisa.

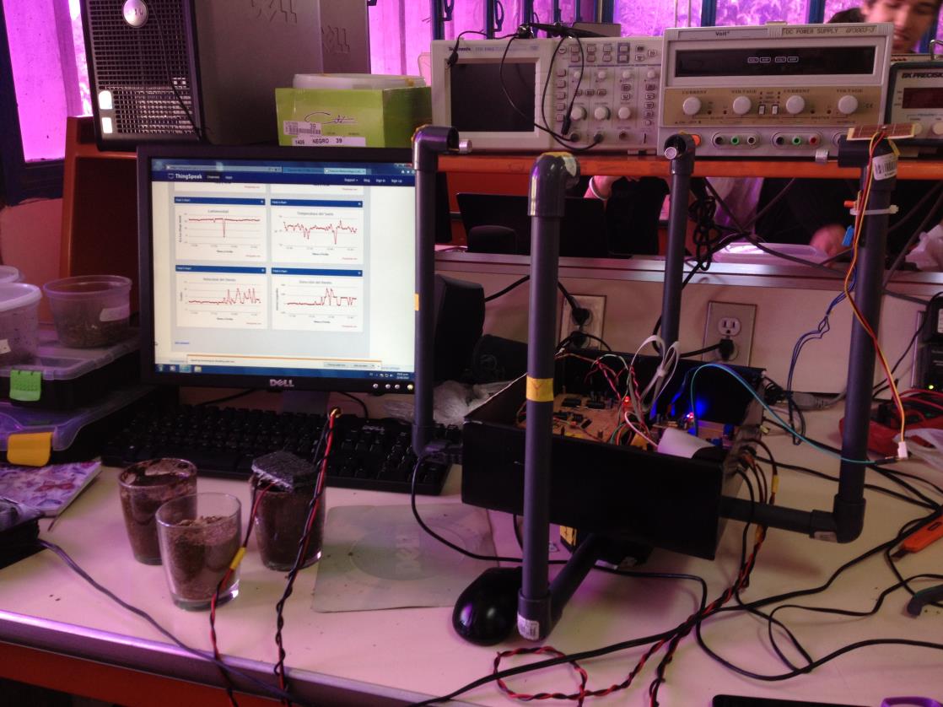
[picture p37: figure]

Figura 39 Estación Metereológica

## REFERENCIAS

1. Variacio n de la velocidad del sonido con la temperatura. Consulta desde http://www.sc.ehu.es/sbweb/fisica_//ondas/acustica/sonido/sonido1.html
2. Ultrasonic Anemometer (Wind speed and direction). Consulta desde http://www.technik.dhbw-ravensburg.de/~lau/ultrasonic-anemometer.html
3. Circuit explanation of Ultrasonic Range Meter unit. Consulta desde http://www.sxlist.com/images/www/hobby_elec/e_srm1_4.htm
4. Ultrasonic Anemometer Project. Consulta desde https://code.google.com/p/mysudoku/downloads/detail?name=UltrasonicAnemometer.zip&can=2&q
5. Arduino Ultrasonic MAX232. Consulta desde: http://arduinomo.com/articles/Module/ultrasonic-max232 (http://arduinomo.com/articles/Module/ultrasonic-max232)
6. Making a Better HC-SR04 Echo Locator. Consulta desde: http://uglyduck.ath.cx/ep/archive/2014/01/Making_a_better_HC_SR04_Echo_Locator.html
7. Datasheets :
Componente | Fabricante
MCP9700A | Microchip
LM311 | Texas Instrument
MAX232 | Texas Instruments
SN74LS14N | Texas Instruments
LM2940CT | Texas Instruments
LM324N | Fairchild Semiconductor
DHT11 | Aosong(Guangzhou) Electronics Co.,Ltd
ATMEGA328P-PU | Atmel
8. Appendix B: Soil Resistivity Measurements. Consulta desde: http://www.lmrsitestandard.com/wp-content/blogs.dir/2/files/2012/09/Appendix-B-Motorola-R56-09-01-05.pdf (http://www.lmrsitestandard.com/wp-content/blogs.dir/2/files/2012/09/Appendix-B-Motorola-R56-09-01-05.pdf)
9. Revista Make. Volumen 18, pa ginas 92-99. Consulta desde: http://www.make-digital.com/make/vol18/?pg=94#pg94 (http://www.make-digital.com/make/vol18/?pg=94#pg94)
10. Gardenbot – The Soil Moisture Sensor. Consulta desde: http://gardenbot.org/howTo/soilMoisture/
11. How to measure temperature with Arduino and MCP9700. Consulta desde: http://starter-kit.nettigo.eu/2010/how-to-measure-temperature-with-arduino-and-mcp9700/ (http://starter-kit.nettigo.eu/2010/how-to-measure-temperature-with-arduino-and-mcp9700/)
12. DHT11 Humidity & Temperature Sensor. Consulta desde: http://www.micro4you.com/files/sensor/DHT11.pdf

13. Configuracio n de pines - DEMÓQE128. Consulta desde: http://wikitronica.labc.usb.ve/index.php/Configuraci%C3%B3n_de_pines-DEMOQE128
14. Processing and Twitter. Consulta desde: http://codasign.com/tutorials/processing-and-twitter/
15. Quick Tutorial – Processing & Twitter. Consulta desde: http://blog.blprnt.com/blog/blprnt/updated-quick-tutorial-processing-twitter (http://blog.blprnt.com/blog/blprnt/updated-quick-tutorial-processing-twitter)
16. C4P (GUI for Processing). Consulta desde: http://www.lagers.org.uk/g4p/
17. Weather Station. Consulta desde: http://make.larsi.org/WeatherStation/
18. ThingSpeak Channels. Consulta desde: http://community.thingspeak.com/tutorials/thingspeak-channels/
