ddtdanilo/Weather-Station-with-DemoQE128-Estacion-Meteorologica-/SINGUI_actual/data/FondoNeg.jpg

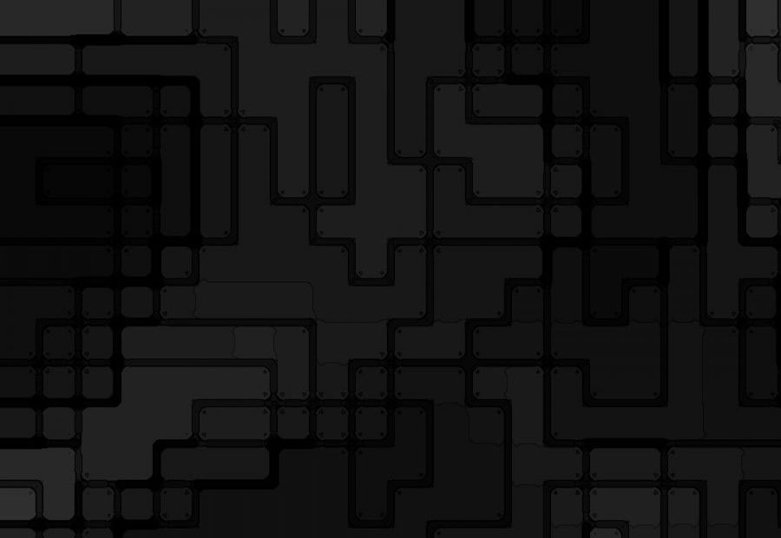
SINGUI_actual/data/FondoNeg.jpg
