ddtdanilo/Weather-Station-with-DemoQE128-Estacion-Meteorologica-/SINGUI_actual/fondoN.jpg

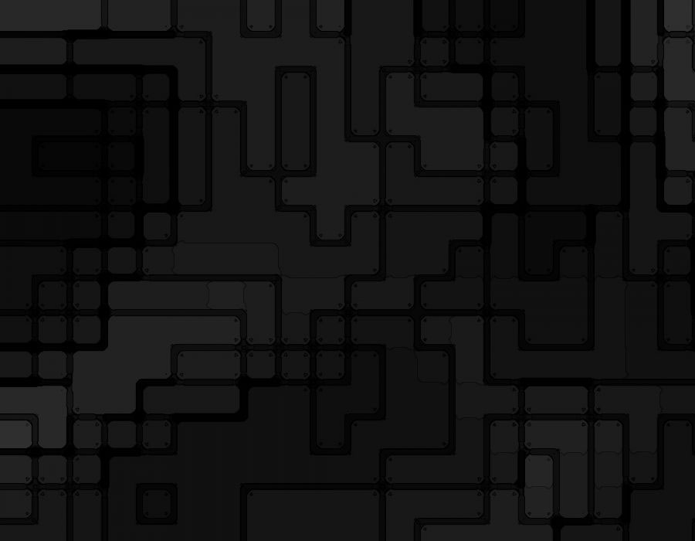
SINGUI_actual/fondoN.jpg
