ddtdanilo/Weather-Station-with-DemoQE128-Estacion-Meteorologica-/(list of files, cad)

Other CAD files:
Estacion_Metereologica_MCU/FLASH/Generated_Code/Vectors_c.obj
Estacion_Metereologica_MCU/FLASH/Project_Settings/Startup_Code/start08_c.obj
Estacion_Metereologica_MCU/FLASH/Sources/Estacion_Metereologica_c.obj
Estacion_Metereologica_MCU/FLASH/Generated_Code/Tiempo_2_c.obj
Estacion_Metereologica_MCU/FLASH/Sources/ProcessorExpert_c.obj
Estacion_Metereologica_MCU/FLASH/Generated_Code/PE_Timer_c.obj
Estacion_Metereologica_MCU/FLASH/Sources/Events_c.obj
Estacion_Metereologica_MCU/FLASH/Generated_Code/AD1_c.obj
Estacion_Metereologica_MCU/FLASH/Generated_Code/Senal_25u_2_c.obj
Estacion_Metereologica_MCU/FLASH/Generated_Code/S1_c.obj
Estacion_Metereologica_MCU/FLASH/Generated_Code/Entrada_Anemometro_2_c.obj
Estacion_Metereologica_MCU/FLASH/Generated_Code/S2_c.obj
Estacion_Metereologica_MCU/FLASH/Generated_Code/Senal_25u_c.obj
Estacion_Metereologica_MCU/FLASH/Generated_Code/IO_Map_c.obj
Estacion_Metereologica_MCU/FLASH/Generated_Code/Tiempo_c.obj
Estacion_Metereologica_MCU/FLASH/Generated_Code/S2_LED_c.obj
Estacion_Metereologica_MCU/FLASH/Generated_Code/Cpu_c.obj
Estacion_Metereologica_MCU/FLASH/Generated_Code/S1_LED_c.obj
Estacion_Metereologica_MCU/FLASH/Generated_Code/Entrada_Anemometro_1_c.obj
