ddtdanilo/Weather-Station-with-DemoQE128-Estacion-Meteorologica-/SINGUI_actual/DrawArrow.pde

void drawArrow(int cx, int cy, int len, float angle){
  pushMatrix();
  translate(cx, cy);
  rotate(radians(angle));
  line(0,0,len, 0);
  line(len, 0, len - 8, -8);
  line(len, 0, len - 8, 8);
  popMatrix();
}
