ddtdanilo/Weather-Station-with-DemoQE128-Estacion-Meteorologica-/SINGUI_actual/Twitter.pde

// Initial connection  - Twitter
void connectTwitter() {
  twitter.setOAuthConsumer(OAuthConsumerKey, OAuthConsumerSecret);
  AccessToken accessToken = loadAccessToken();
  twitter.setOAuthAccessToken(accessToken);
}

// Sending a tweet
void sendTweet(String t) {

  try {
    Status status = twitter.updateStatus(t);
    println("Successfully updated the status to [" + status.getText() + "].");
  } catch(TwitterException e) { 
    println("Send tweet: " + e + " Status code: " + e.getStatusCode());
  }

}

// Loading up the access token

private static AccessToken loadAccessToken(){ 
 return new AccessToken(AccessToken, AccessTokenSecret);   
}
